PappaBears/Benairy-Windtunnel/cad/sweep_report.md

# Swept-angle interference check (generated by cad/check_sweep.py)

Metric parts rotated about the drum axis at x = 185, z = -65 mm.

| Configuration | Angle (deg) | Overlaps (part A / part B / mm3) |
|---|---|---|
| wing | -30 | strut_long / test_section_2 / 5.1 |
| wing | -25 | none |
| wing | -20 | none |
| wing | -15 | none |
| wing | -10 | none |
| wing | -5 | none |
| wing | +0 | none |
| wing | +5 | none |
| wing | +10 | none |
| wing | +15 | none |
| wing | +20 | none |
| wing | +25 | none |
| wing | +30 | none |
| car | -3 | none |
| car | -2 | none |
| car | -1 | none |
| car | +0 | none |
| car | +1 | none |
| car | +2 | none |
| car | +3 | none |

**Result: FAIL**
