PappaBears/Benairy-Windtunnel/docs/generated/design_numbers.md

# Design numbers (generated by tools/design_calcs.py)

Do not edit this file. Run the script again to update it.

## Operating point

| Quantity | Value |
|---|---|
| Fan | ARCTIC S12038-8K (120x120x38 mm, PWM, 12 V, 2.2 A) |
| Test section | 100 x 100 mm, 250 mm long |
| Contraction ratio | 4.0 |
| Total loss coefficient (on test-section q) | 1.63 |
| Volume flow | 0.0914 m^3/s (194 CFM) |
| Test-section speed | 9.1 m/s |
| Dynamic pressure q | 50.1 Pa |
| Fan pressure rise at this point | 82 Pa |
| Reynolds number on Dh | 60592 |
| Floor boundary layer at the model, laminar / turbulent | 2.7 / 6.5 mm |
| Turbulence factor, 2 screens x contraction | 0.145 |

## Loss coefficients

| Element | K (on q_ts) |
|---|---|
| honeycomb | 0.067 |
| screens | 0.090 |
| contraction | 0.020 |
| test_section | 0.050 |
| diffuser | 0.150 |
| exit | 1.153 |
| guard_and_model | 0.100 |
| total | 1.631 |

## Forces at the operating point

| Model | Quantity | Value |
|---|---|---|
| Wing 80 x 35 mm | Re (chord) | 21207 |
| Wing 80 x 35 mm | Lift at CL = 0.8 | 11.45 gf (112.3 mN) |
| Wing 80 x 35 mm | Drag at CD = 0.04 | 0.57 gf |
| Wing 80 x 35 mm | Drag at CD = 0.25 | 3.58 gf |
| Wing 80 x 35 mm | Frontal blockage at 15 deg | 7.2 % |
| 1:64 car | Re (length) | 45444 |
| 1:64 car | Drag at CD = 0.5 | 1.51 gf (14.8 mN) |
| 1:64 car | Lift at CL = 0.2 | 0.60 gf |
| 1:64 car | Frontal blockage | 5.9 % |
| Strut, airfoil section | Drag (tare) | 0.06 gf |
| Strut, round 3.5 mm rod | Drag (tare) | 0.80 gf |

## Balance budget (100 g drag cell, 200 g lift cell, HX711, 1 s average)

| Quantity | Value |
|---|---|
| Noise, 1 sigma | 0.010 g |
| Non-linearity | 0.050 g |
| Creep (half, after tare) | 0.015 g |
| Combined drag-cell uncertainty (100 g cell), 1 sigma | 0.053 g |
| Combined lift-cell uncertainty (200 g cell), 1 sigma | 0.105 g |
| Car drag, relative uncertainty | 3.5 % |
| Wing lift at CL 0.8, relative uncertainty | 0.9 % |
| Wing drag at CD 0.04, relative uncertainty | 9.3 % |

## Dynamic pressure budget (SDP810-125Pa)

| Quantity | Value |
|---|---|
| q uncertainty, 1 sigma | 1.51 Pa (3.0 %) |
| Speed uncertainty, 1 sigma | 1.5 % |
