PappaBears/Benairy-Windtunnel/cad/renders/rear_quarter.png

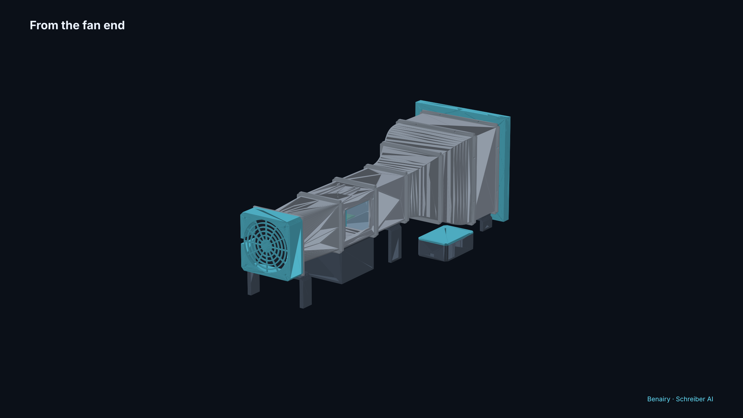
cad/renders/rear_quarter.png
