PappaBears/Benairy-Windtunnel/cad/renders/side.png

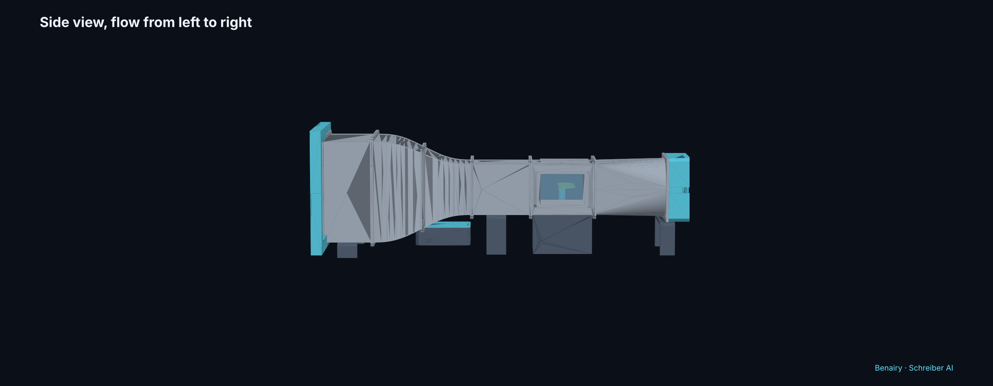
cad/renders/side.png
