PappaBears/Benairy-Windtunnel/cad/renders/sweep_arc.png

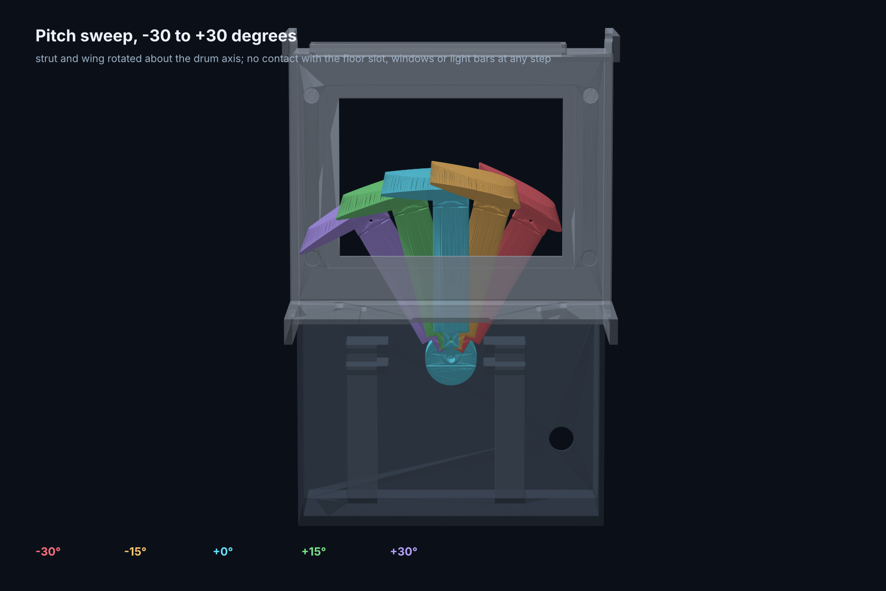
cad/renders/sweep_arc.png
