PappaBears/Benairy-Windtunnel/docs/images/dashboard_phone.png

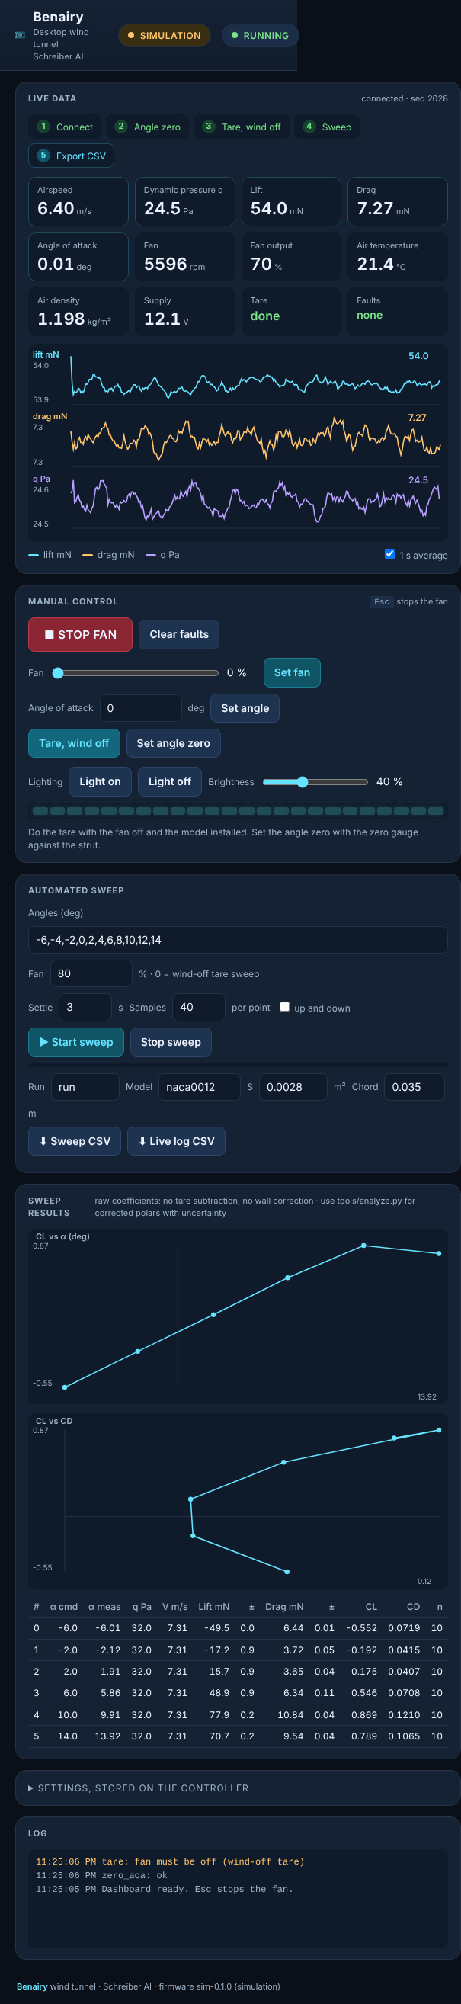
docs/images/dashboard_phone.png
