PappaBears/Benairy-Windtunnel/docs/images/dashboard_standalone_fault.png

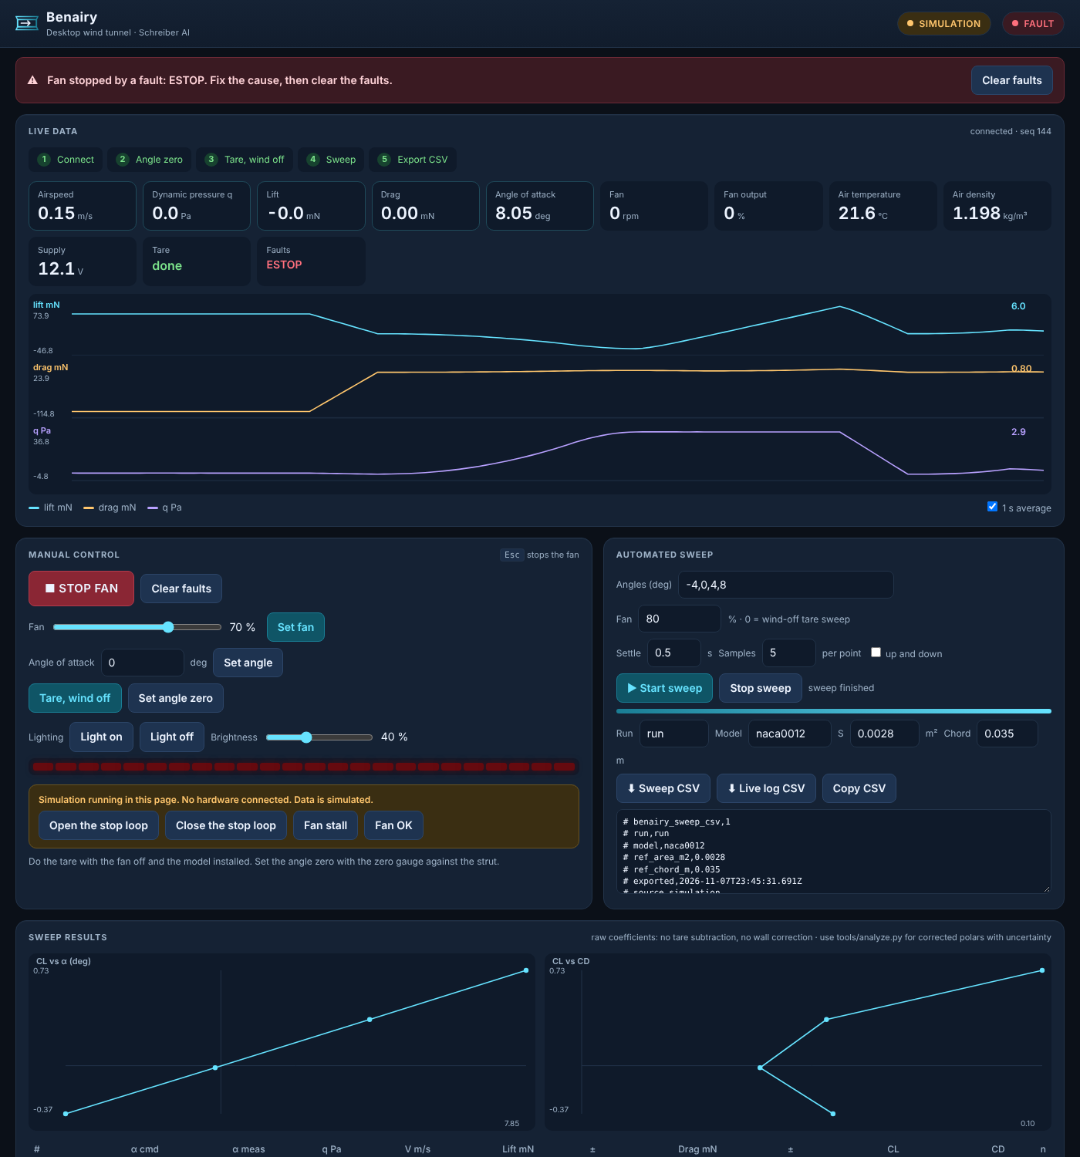
docs/images/dashboard_standalone_fault.png
