PappaBears/Benairy-Windtunnel/cad/renders/parts_gallery.png

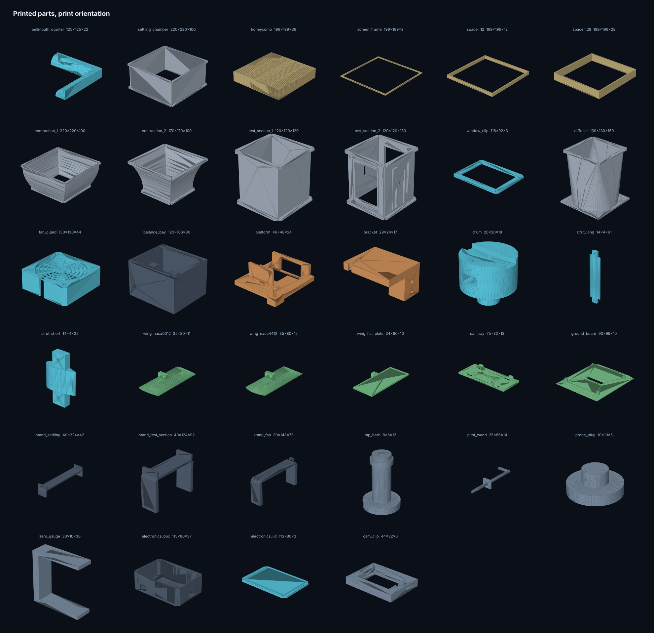
cad/renders/parts_gallery.png
