PappaBears/Benairy-Windtunnel/cad/assembly_stl/ground_board.stl

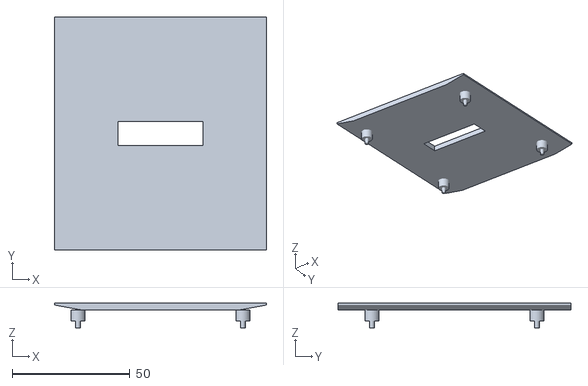
[picture p13: CAD file, 2026-11-08]
cad/assembly_stl/ground_board.stl
90.0 x 99.0 x 10.5
