PappaBears/Benairy-Windtunnel/cad/step/electronics_lid.step

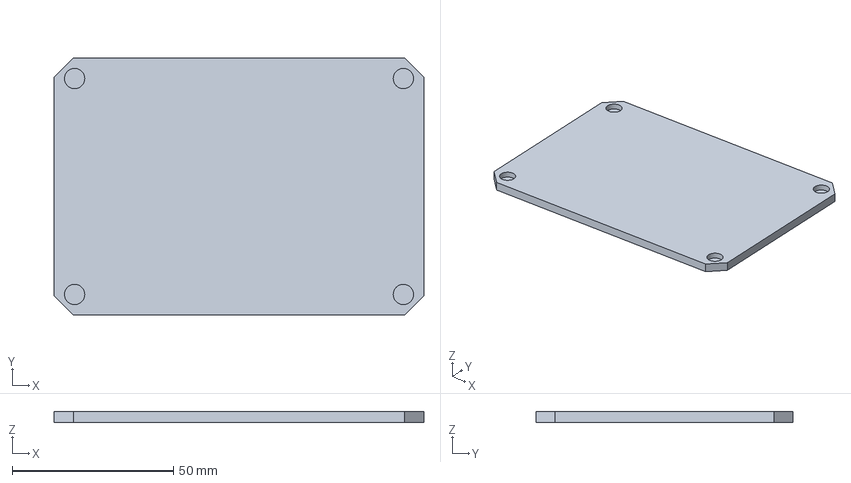
[picture p14: CAD file, 2026-11-08]
cad/step/electronics_lid.step
114.8 x 79.8 x 3.40 mm
