PappaBears/Benairy-Windtunnel/cad/assembly_stl/ref_led_strip_R.stl

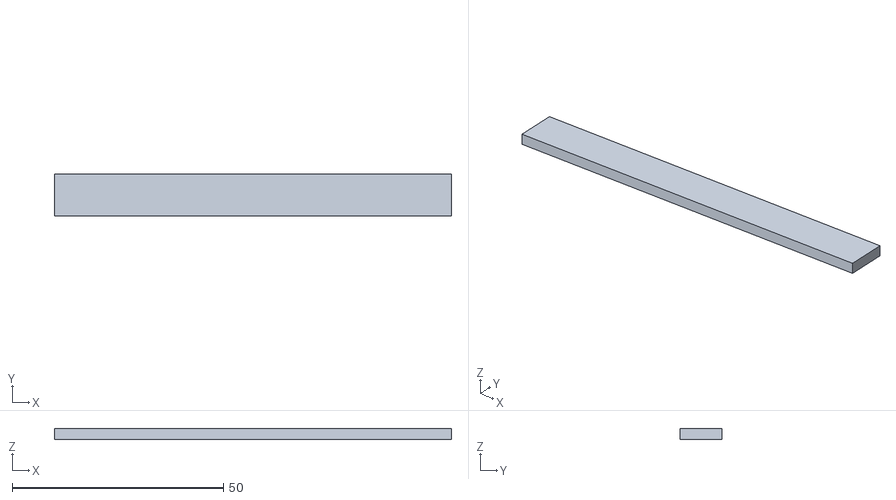
[picture p15: CAD file, 2026-11-07]
cad/assembly_stl/ref_led_strip_R.stl
94.0 x 10.0 x 2.60
