PappaBears/Benairy-Windtunnel/cad/step/settling_chamber.step

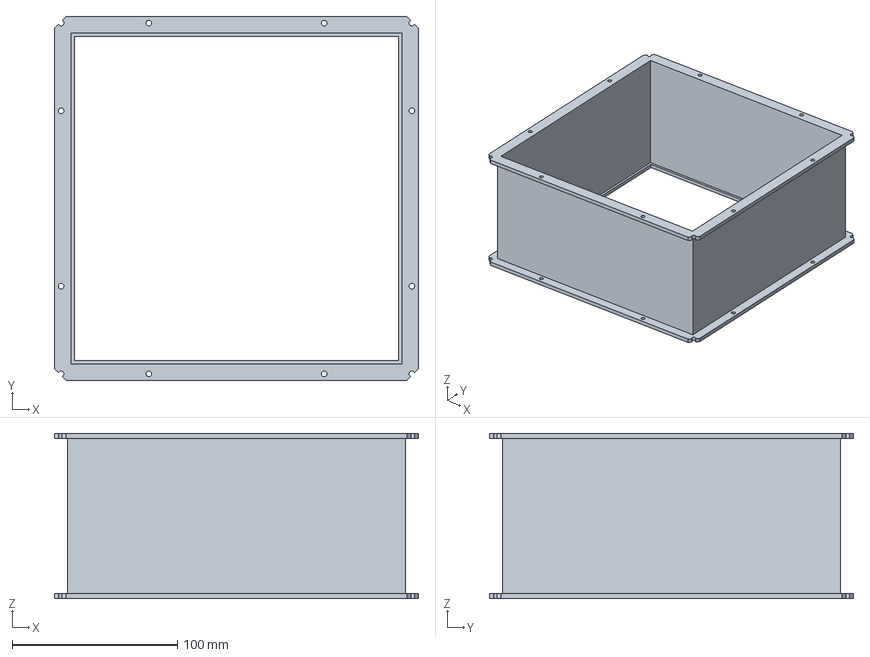
[picture p16: CAD file, 2026-11-08]
cad/step/settling_chamber.step
220.0 x 220.0 x 100.0 mm
