PappaBears/Benairy-Windtunnel/cad/step/wing_naca4412.step

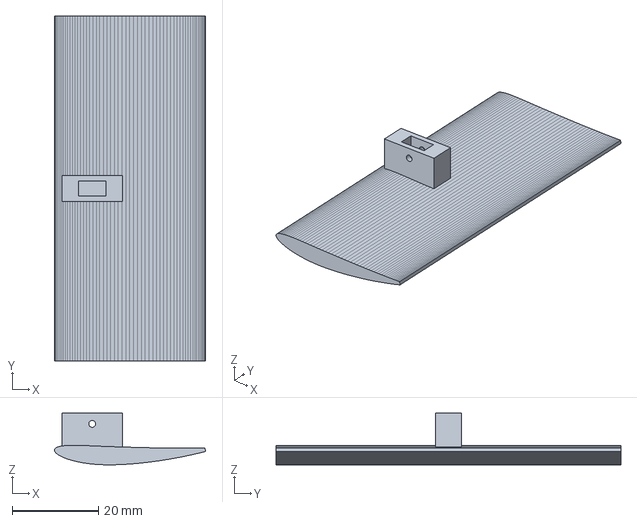
[picture p17: CAD file, 2026-11-08]
cad/step/wing_naca4412.step
35.1 x 80.0 x 12.0 mm
