PappaBears/Benairy-Windtunnel/cad/assembly_stl/test_section_2.stl

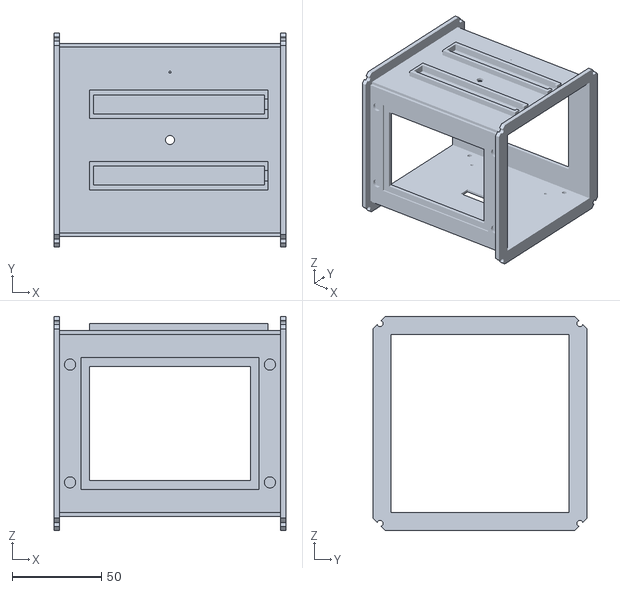
[picture p18: CAD file, 2026-11-07]
cad/assembly_stl/test_section_2.stl
130.0 x 120.0 x 120.0
