PappaBears/Benairy-Windtunnel/cad/step/diffuser.step

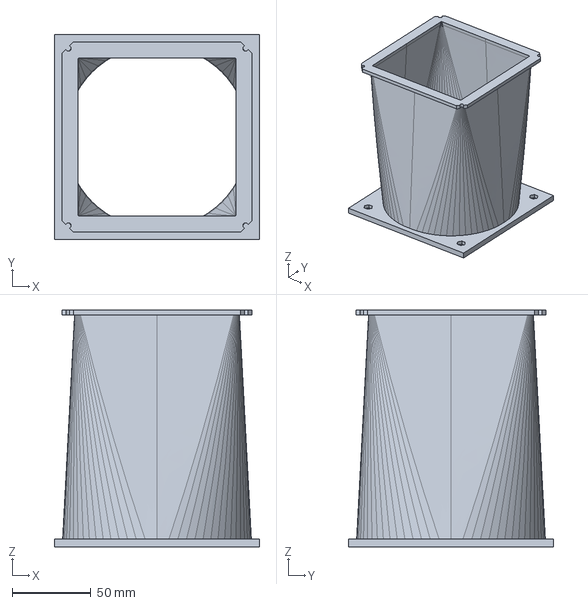
[picture p19: CAD file, 2026-11-08]
cad/step/diffuser.step
130.0 x 130.0 x 150.0 mm
