PappaBears/Benairy-Windtunnel/cad/assembly_stl/stand_fan.stl

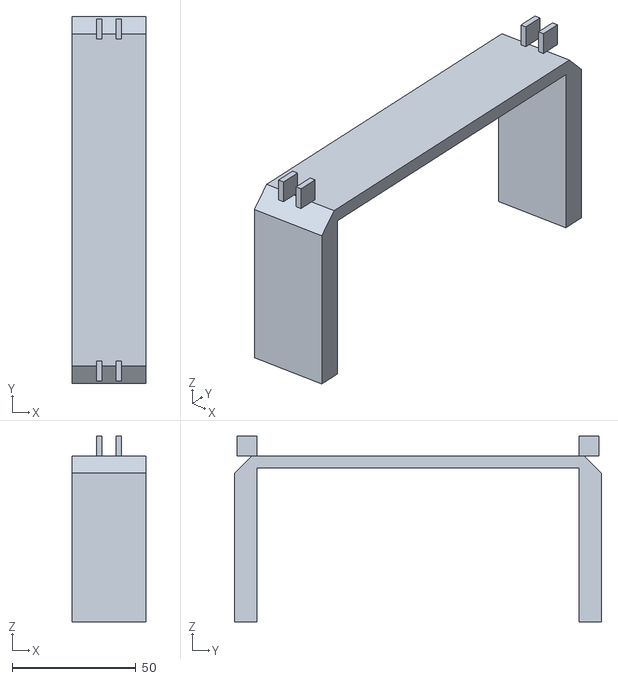
[picture p20: CAD file, 2026-11-07]
cad/assembly_stl/stand_fan.stl
30.0 x 148.0 x 75.0
