PappaBears/Benairy-Windtunnel/cad/step/platform.step

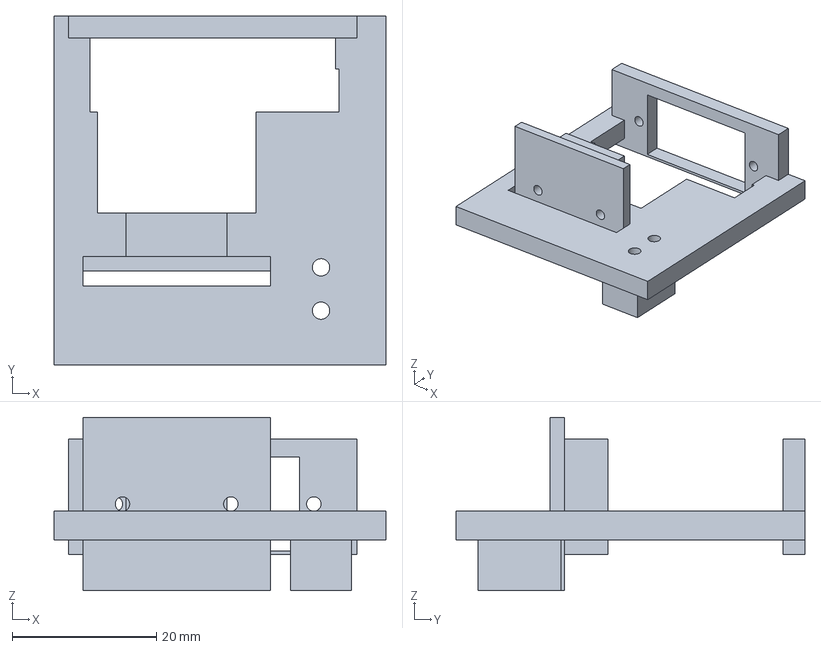
[picture p21: CAD file, 2026-11-08]
cad/step/platform.step
46.0 x 48.3 x 24.0 mm
