PappaBears/Benairy-Windtunnel/cad/assembly_stl/stand_test_section.stl

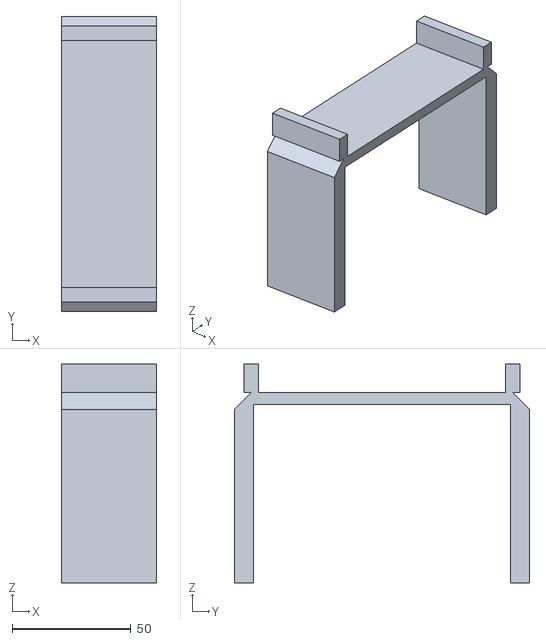
[picture p22: CAD file, 2026-11-07]
cad/assembly_stl/stand_test_section.stl
40.0 x 124.0 x 92.0
