PappaBears/Benairy-Windtunnel/cad/step/wing_flat_plate.step

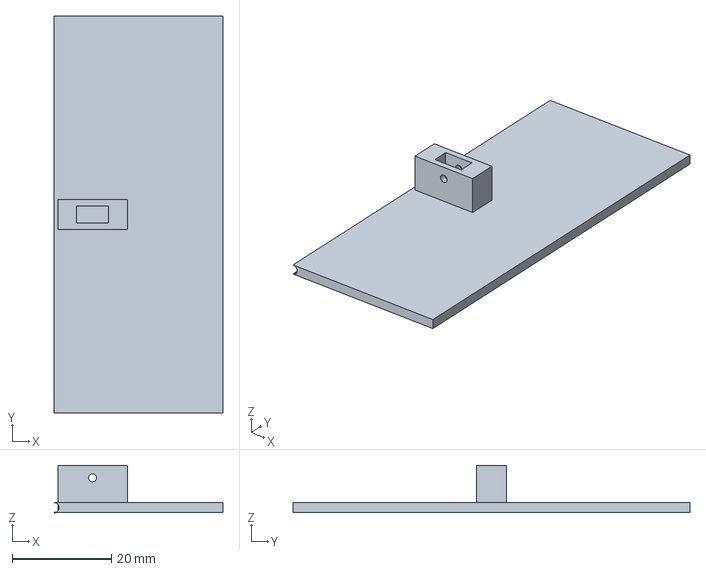
[picture p23: CAD file, 2026-11-08]
cad/step/wing_flat_plate.step
34.0 x 80.0 x 9.50 mm
