PappaBears/Benairy-Windtunnel/cad/step/pitot_wand.step

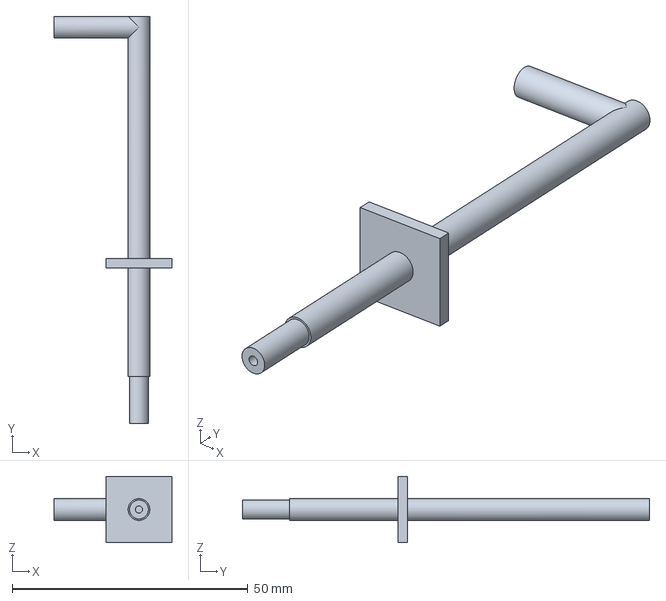
[picture p24: CAD file, 2026-11-08]
cad/step/pitot_wand.step
25.0 x 86.3 x 14.0 mm
