PappaBears/Benairy-Windtunnel/cad/assembly_stl/contraction_2.stl

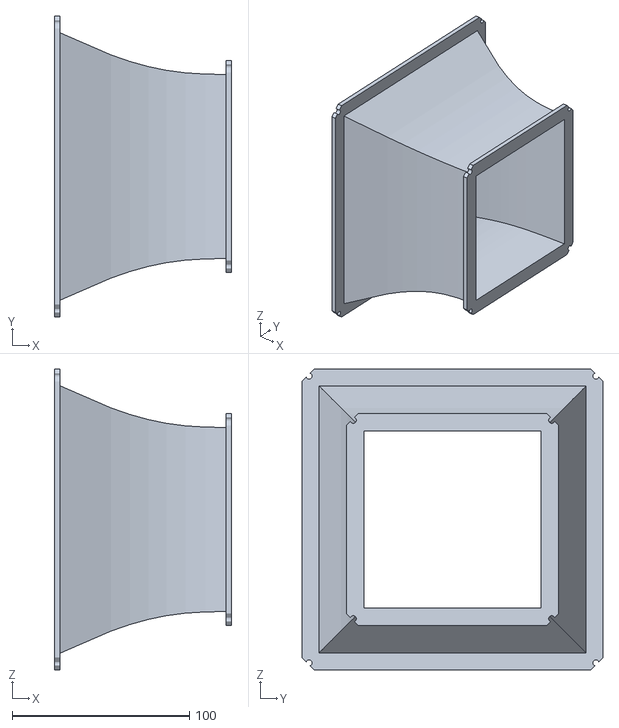
[picture p25: CAD file, 2026-11-07]
cad/assembly_stl/contraction_2.stl
100.0 x 170.0 x 170.0
