PappaBears/Benairy-Windtunnel/cad/step/stand_settling.step

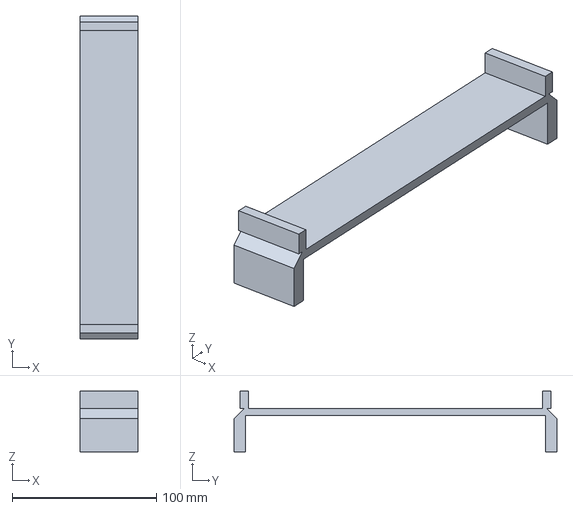
[picture p26: CAD file, 2026-11-08]
cad/step/stand_settling.step
40.0 x 224.0 x 42.0 mm
