PappaBears/Benairy-Windtunnel/cad/assembly_stl/fan_guard.stl

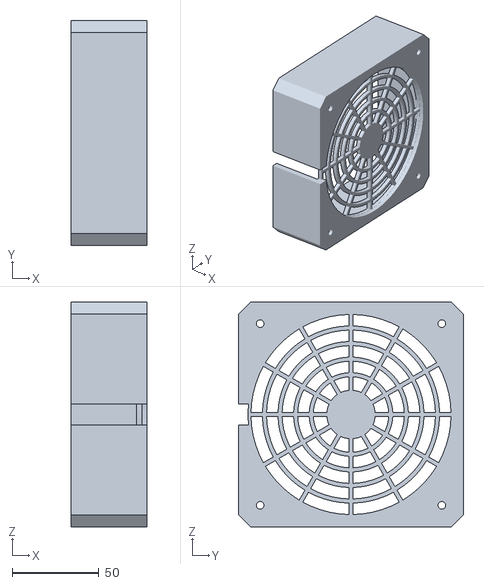
[picture p27: CAD file, 2026-11-07]
cad/assembly_stl/fan_guard.stl
44.0 x 130.0 x 130.0
