PappaBears/Benairy-Windtunnel/cad/assembly_stl/test_section_1.stl

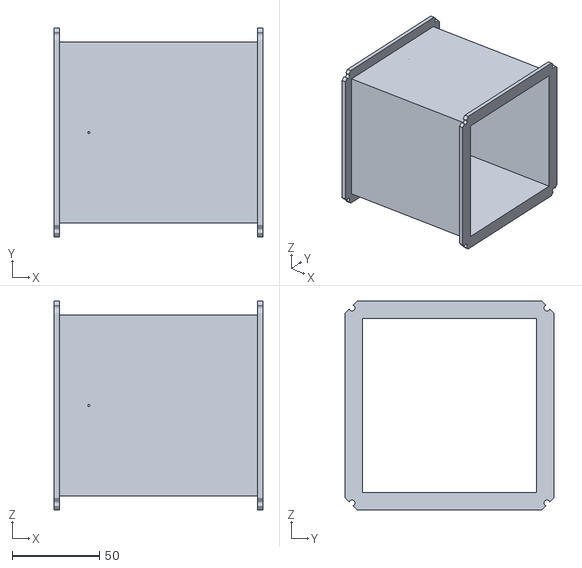
[picture p28: CAD file, 2026-11-07]
cad/assembly_stl/test_section_1.stl
120.0 x 120.0 x 120.0
