PappaBears/Benairy-Windtunnel/cad/step/electronics_box.step

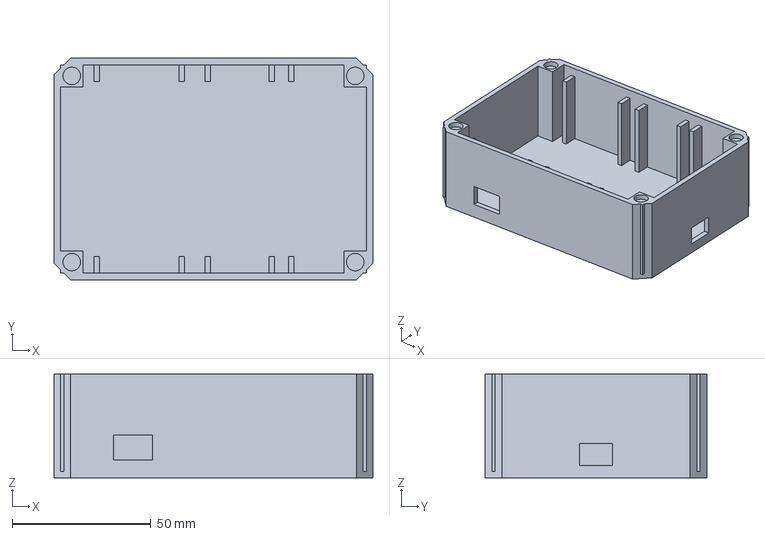
[picture p29: CAD file, 2026-11-08]
cad/step/electronics_box.step
114.8 x 79.8 x 37.4 mm
