PappaBears/Benairy-Windtunnel/cad/assembly_stl/window_clip.stl

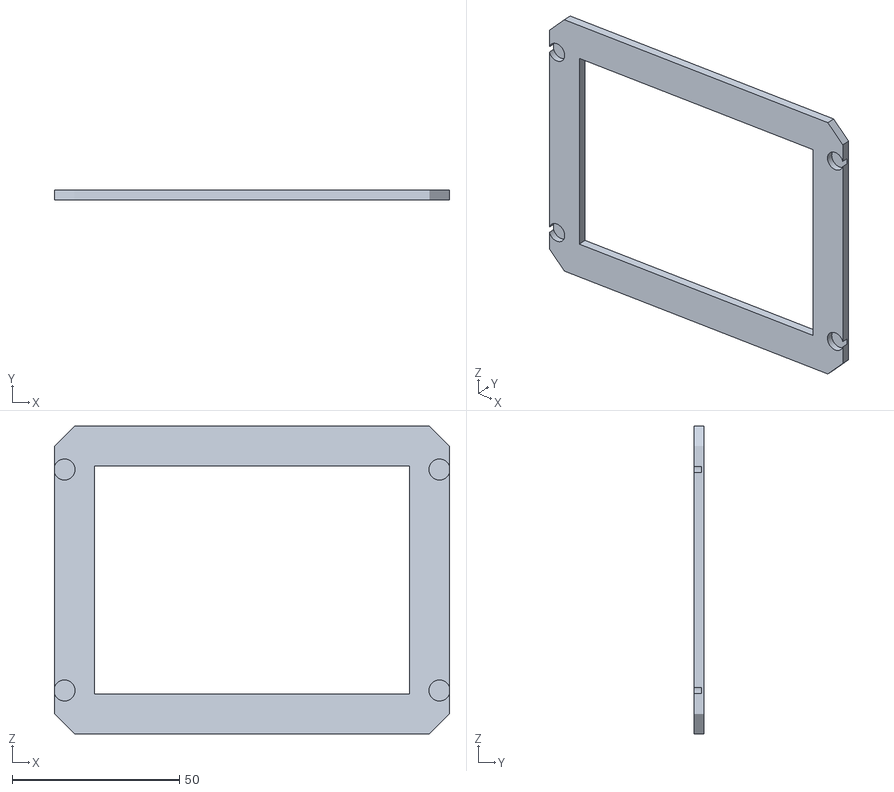
[picture p30: CAD file, 2026-11-07]
cad/assembly_stl/window_clip.stl
118.0 x 3.00 x 92.0
