PappaBears/Benairy-Windtunnel/cad/step/balance_bay.step

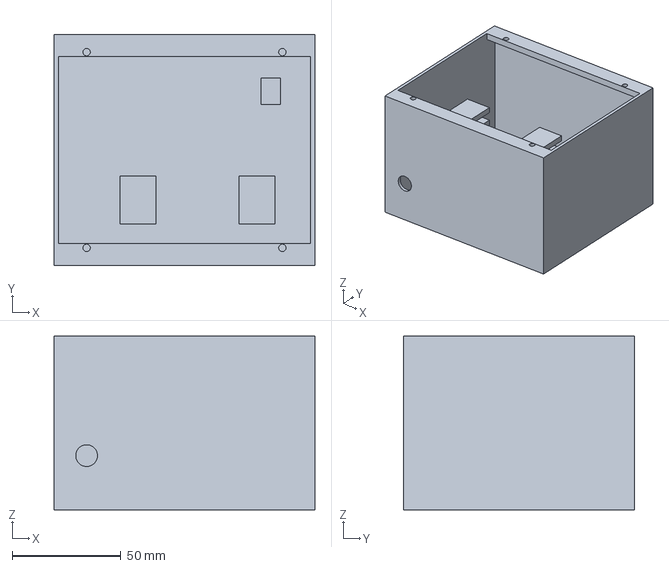
[picture p31: CAD file, 2026-11-08]
cad/step/balance_bay.step
120.0 x 106.0 x 80.0 mm
