PappaBears/Benairy-Windtunnel/cad/step/cam_clip.step

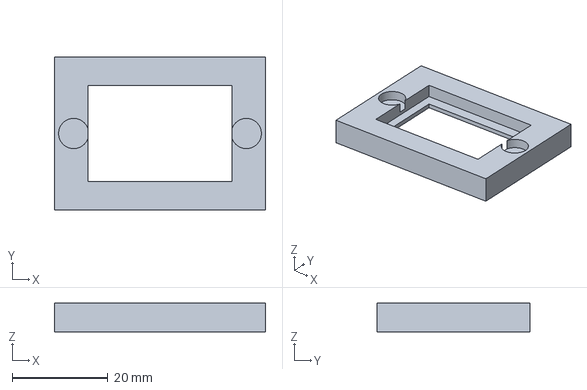
[picture p32: CAD file, 2026-11-08]
cad/step/cam_clip.step
44.0 x 32.0 x 6.00 mm
