PappaBears/Benairy-Windtunnel/cad/assembly_stl/contraction_1.stl

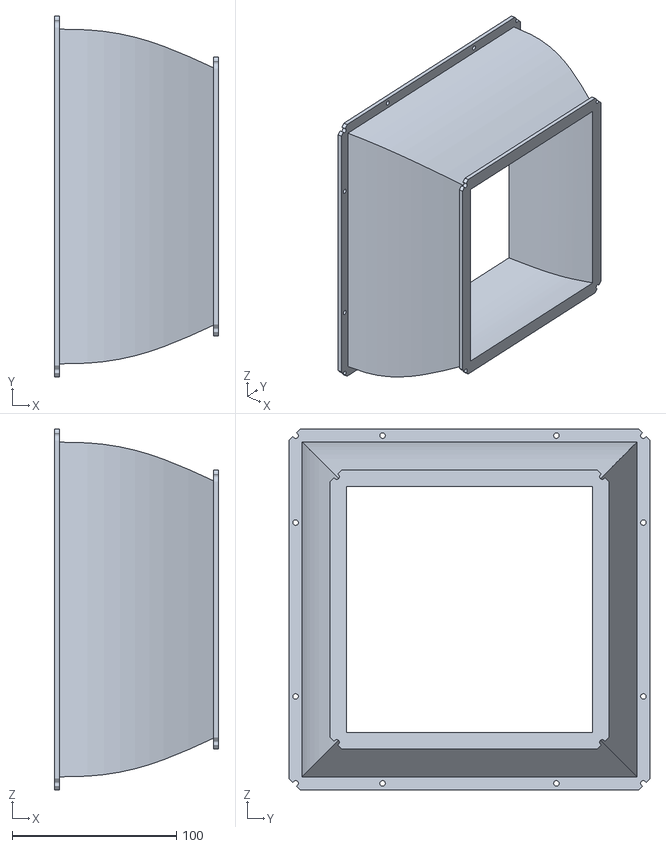
[picture p33: CAD file, 2026-11-07]
cad/assembly_stl/contraction_1.stl
100.0 x 220.0 x 220.0
