PappaBears/Benairy-Windtunnel/cad/step/screen_frame.step

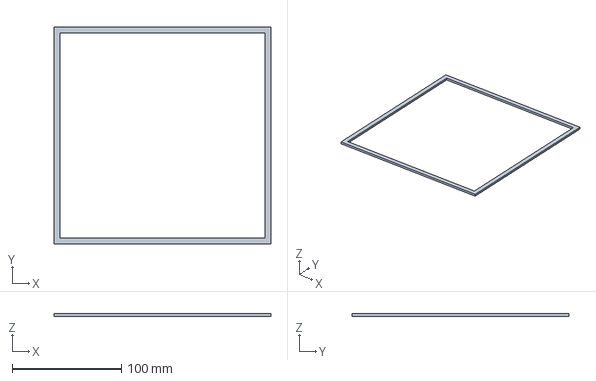
[picture p34: CAD file, 2026-11-08]
cad/step/screen_frame.step
199.0 x 199.0 x 2.50 mm
