PappaBears/Benairy-Windtunnel/cad/assembly_stl/ref_fan.stl

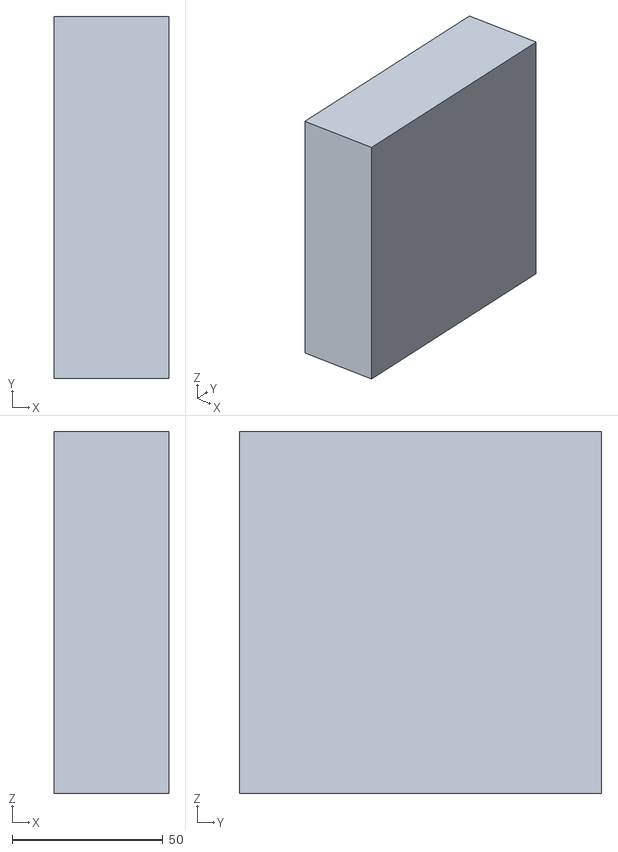
[picture p35: CAD file, 2026-11-07]
cad/assembly_stl/ref_fan.stl
38.0 x 120.0 x 120.0
