PappaBears/Benairy-Windtunnel/cad/step/tap_barb.step

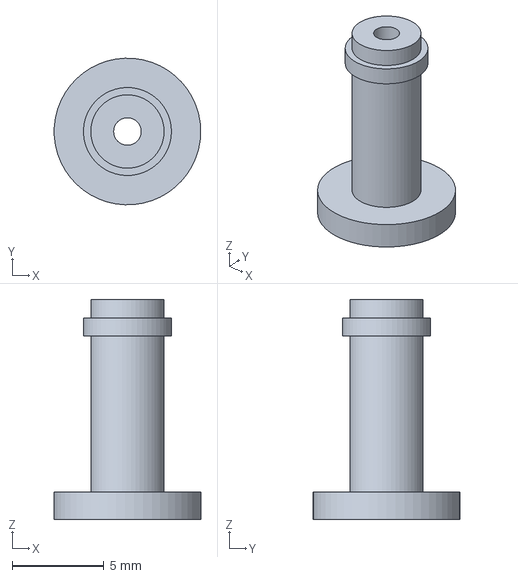
[picture p36: CAD file, 2026-11-08]
cad/step/tap_barb.step
7.99 x 8.00 x 12.0 mm
