PappaBears/Benairy-Windtunnel/cad/step/spacer_28.step

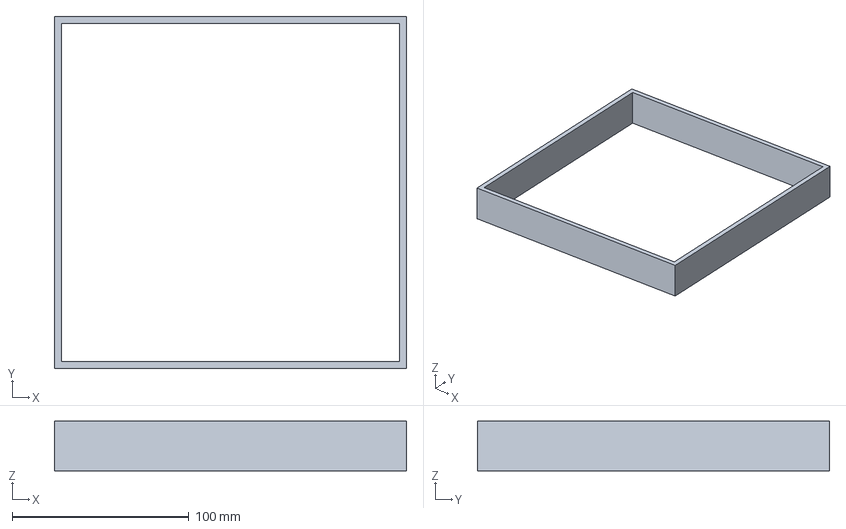
[picture p37: CAD file, 2026-11-08]
cad/step/spacer_28.step
199.0 x 199.0 x 28.0 mm
