PappaBears/Benairy-Windtunnel/cad/assembly_stl/spacer_12.stl

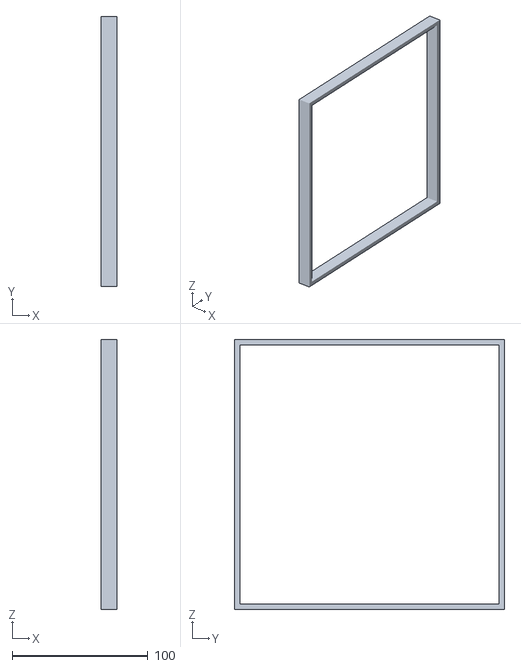
[picture p38: CAD file, 2026-11-07]
cad/assembly_stl/spacer_12.stl
12.0 x 199.0 x 199.0
