PappaBears/Benairy-Windtunnel/cad/step/drum.step

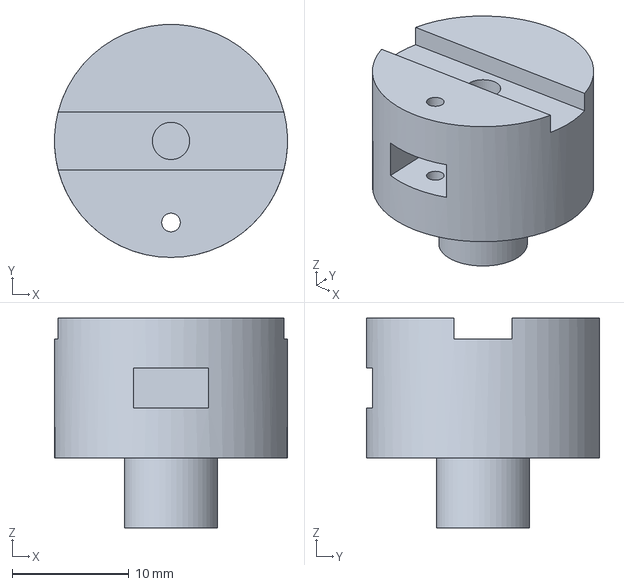
[picture p39: CAD file, 2026-11-08]
cad/step/drum.step
20.0 x 20.0 x 18.0 mm
