PappaBears/Benairy-Windtunnel/cad/step/honeycomb.step

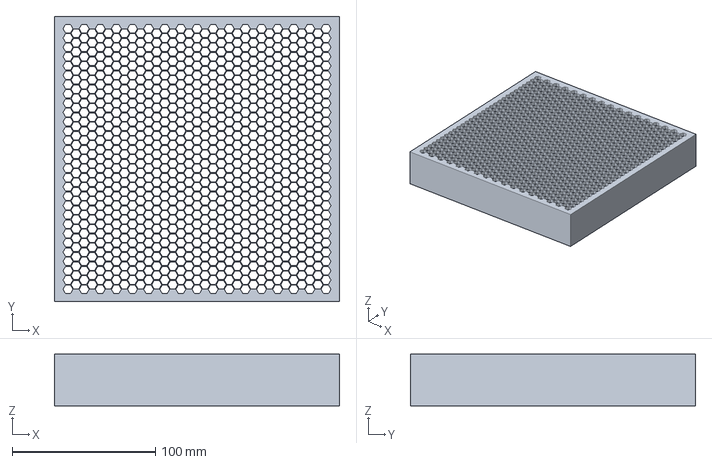
[picture p40: CAD file, 2026-11-08]
cad/step/honeycomb.step
199.0 x 199.0 x 36.0 mm
