PappaBears/Benairy-Windtunnel/cad/assembly_stl/ref_window_sheet_L.stl

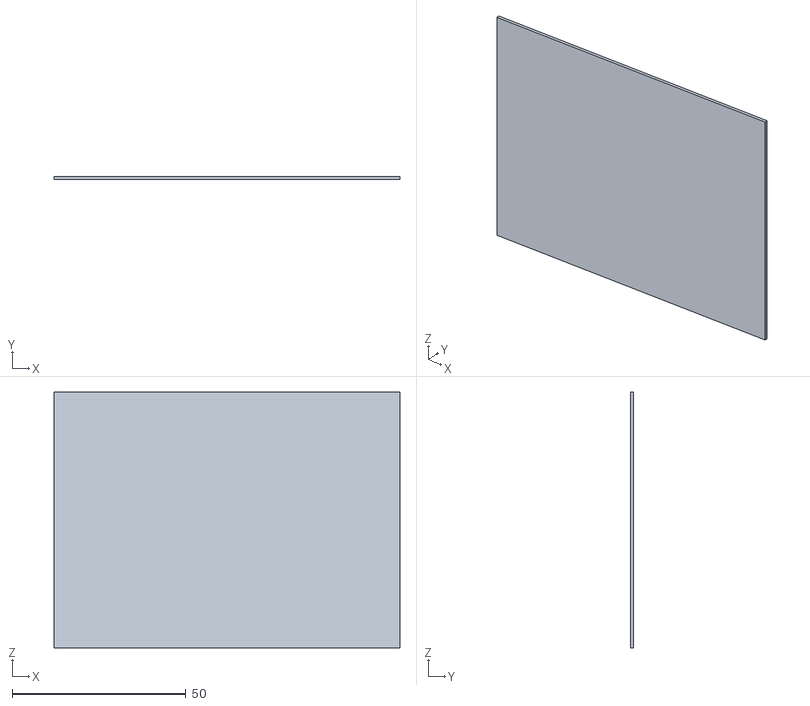
[picture p41: CAD file, 2026-11-07]
cad/assembly_stl/ref_window_sheet_L.stl
99.6 x 1.00 x 73.6
