PappaBears/Benairy-Windtunnel/cad/assembly_stl/bellmouth_quarter.stl

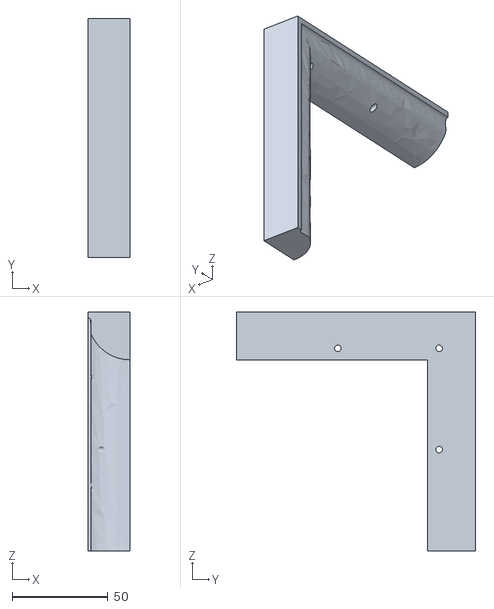
[picture p42: CAD file, 2026-11-07]
cad/assembly_stl/bellmouth_quarter.stl
22.0 x 125.0 x 125.0
