PappaBears/Benairy-Windtunnel/cad/step/probe_plug.step

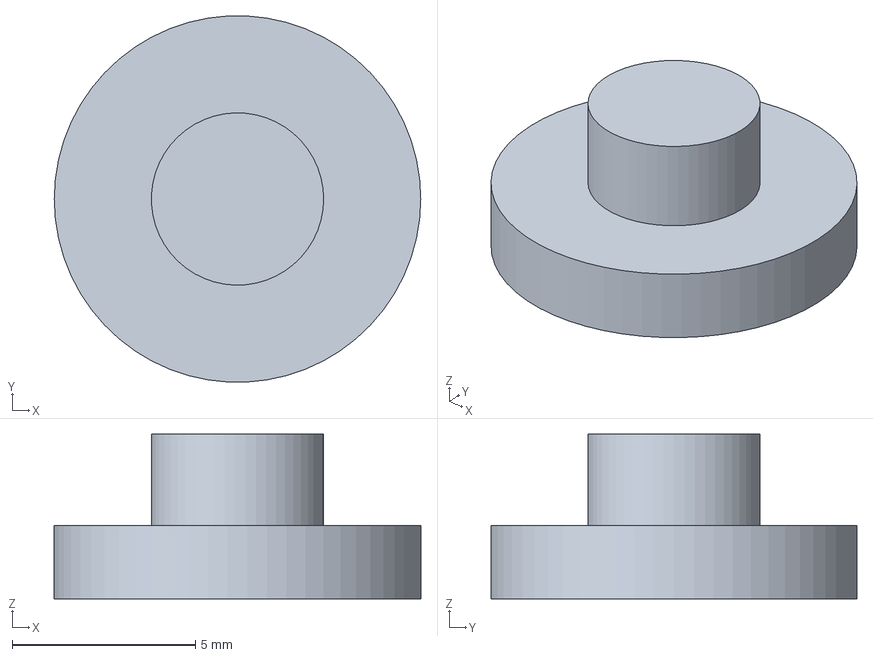
[picture p43: CAD file, 2026-11-08]
cad/step/probe_plug.step
10.0 x 9.99 x 4.50 mm
