PappaBears/Benairy-Windtunnel/cad/assembly_stl/strut_long.stl

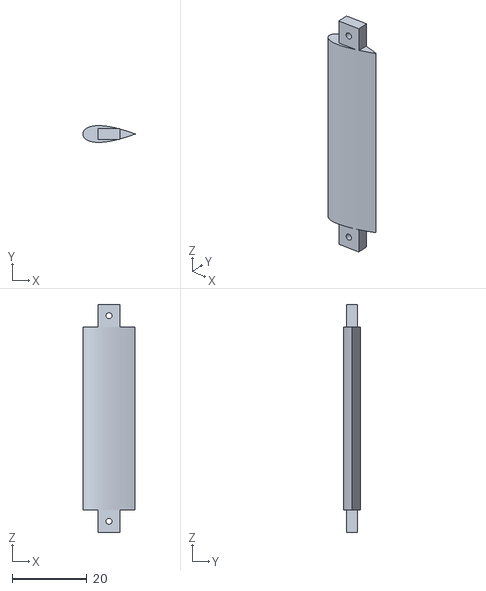
[picture p44: CAD file, 2026-11-07]
cad/assembly_stl/strut_long.stl
14.0 x 4.50 x 61.0
