PappaBears/Benairy-Windtunnel/cad/step/wing_naca0012.step

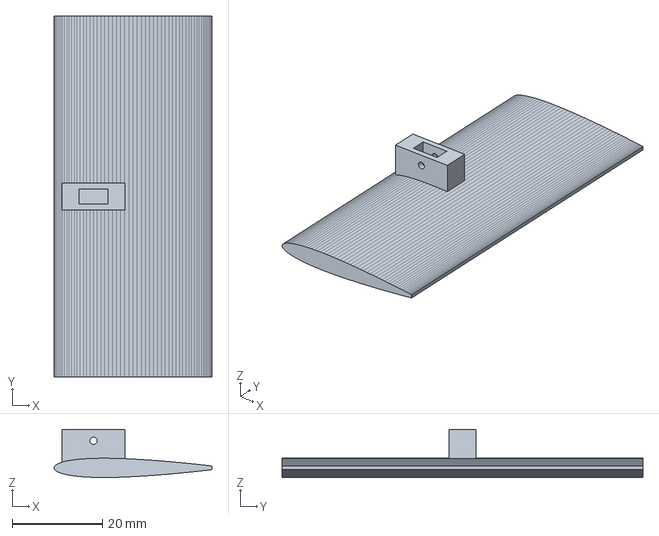
[picture p45: CAD file, 2026-11-08]
cad/step/wing_naca0012.step
35.0 x 80.0 x 10.6 mm
