PappaBears/Benairy-Windtunnel/cad/step/bracket.step

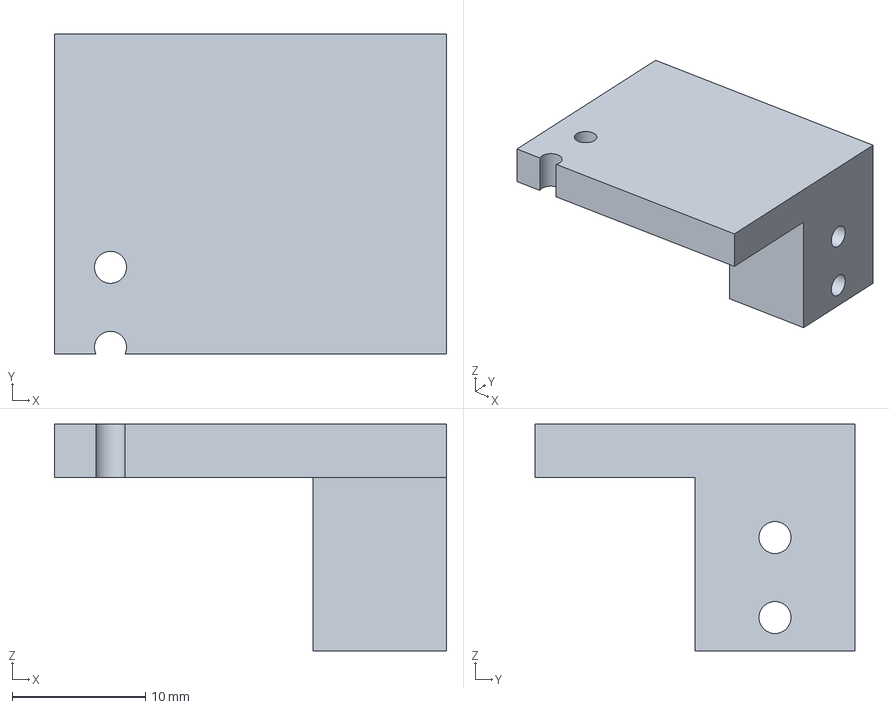
[picture p46: CAD file, 2026-11-08]
cad/step/bracket.step
29.4 x 24.0 x 17.0 mm
