PappaBears/Benairy-Windtunnel/cad/assembly_stl/ref_servo.stl

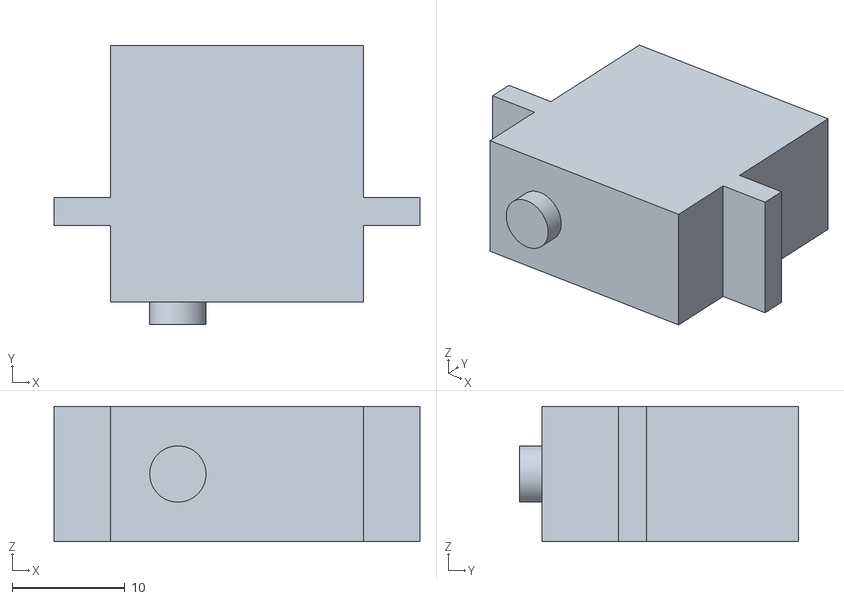
[picture p47: CAD file, 2026-11-07]
cad/assembly_stl/ref_servo.stl
32.5 x 24.8 x 12.0
