PappaBears/Benairy-Windtunnel/cad/step/strut_short.step

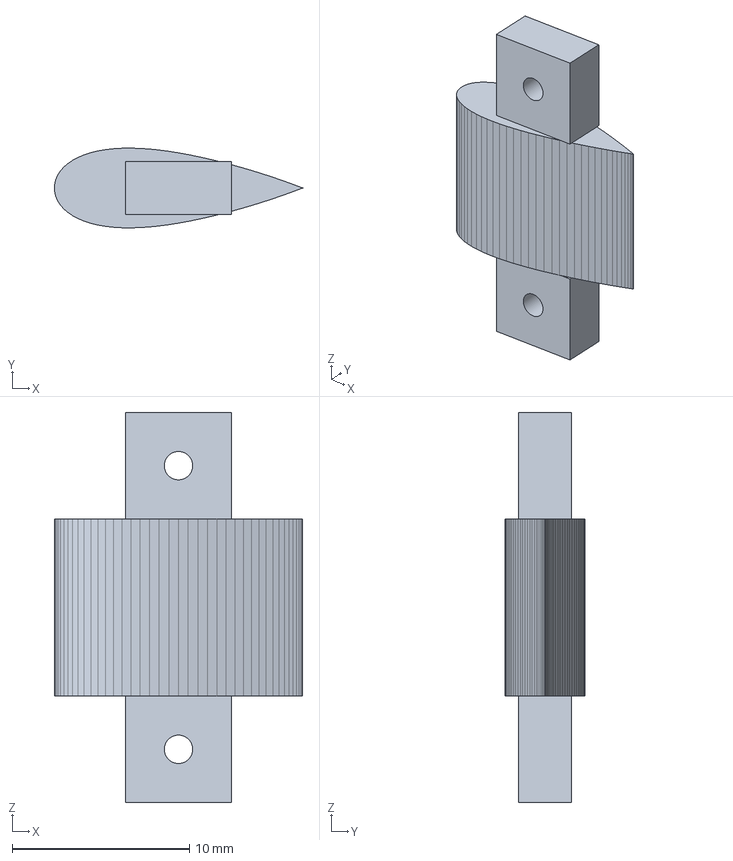
[picture p48: CAD file, 2026-11-08]
cad/step/strut_short.step
14.0 x 4.50 x 22.0 mm
