PappaBears/Benairy-Windtunnel/cad/step/car_tray.step

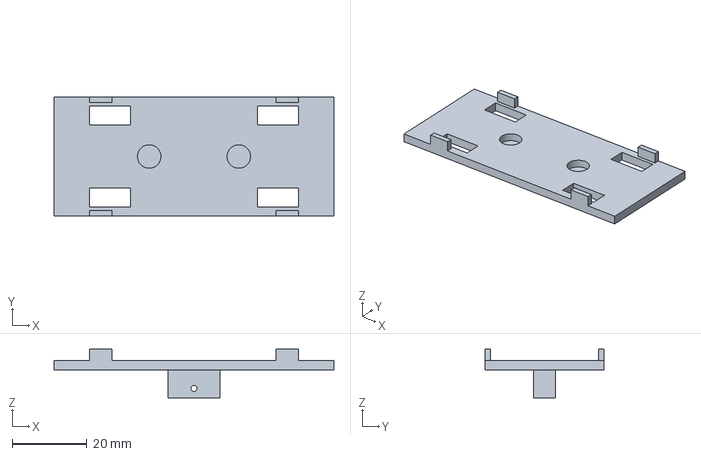
[picture p49: CAD file, 2026-11-08]
cad/step/car_tray.step
75.0 x 32.0 x 13.0 mm
