PappaBears/Benairy-Windtunnel/cad/assembly_stl/ref_lift_cell.stl

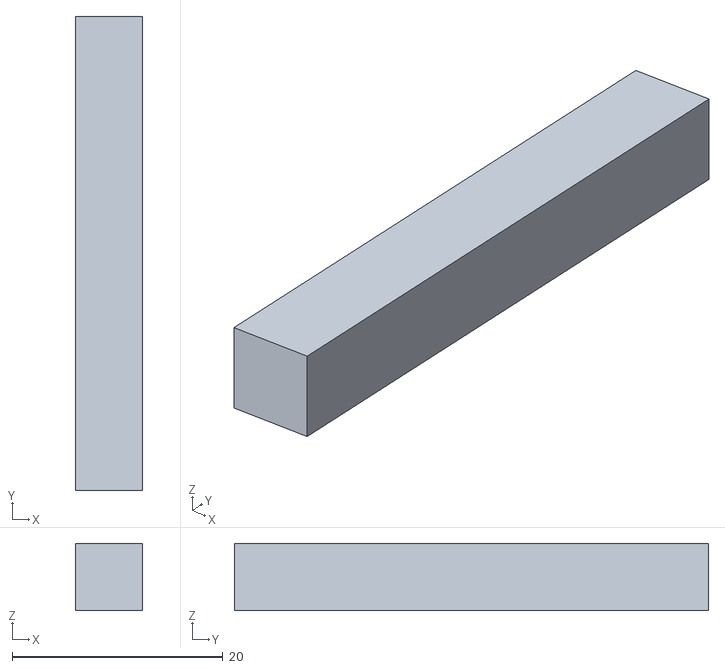
[picture p50: CAD file, 2026-11-07]
cad/assembly_stl/ref_lift_cell.stl
6.40 x 45.0 x 6.40
