PappaBears/Benairy-Windtunnel/cad/step/zero_gauge.step

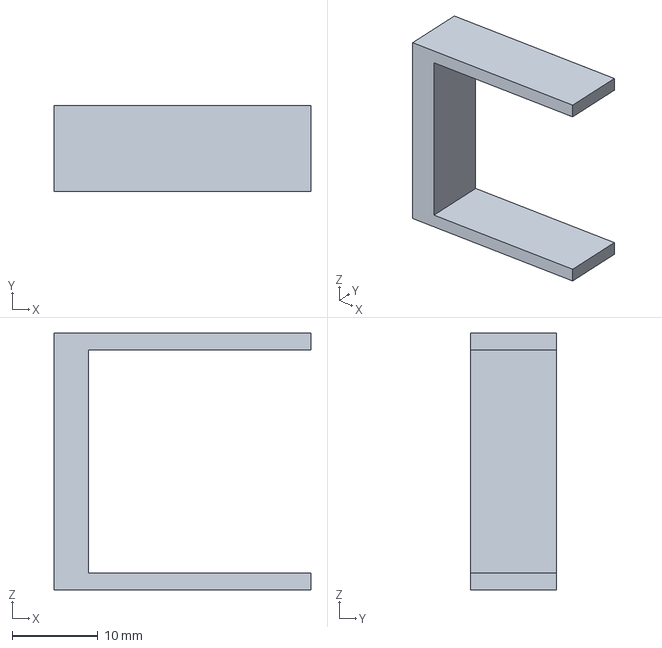
[picture p51: CAD file, 2026-11-08]
cad/step/zero_gauge.step
30.0 x 10.0 x 30.0 mm
