PappaBears/Benairy-Windtunnel/cad/assembly_stl/ref_as5600.stl

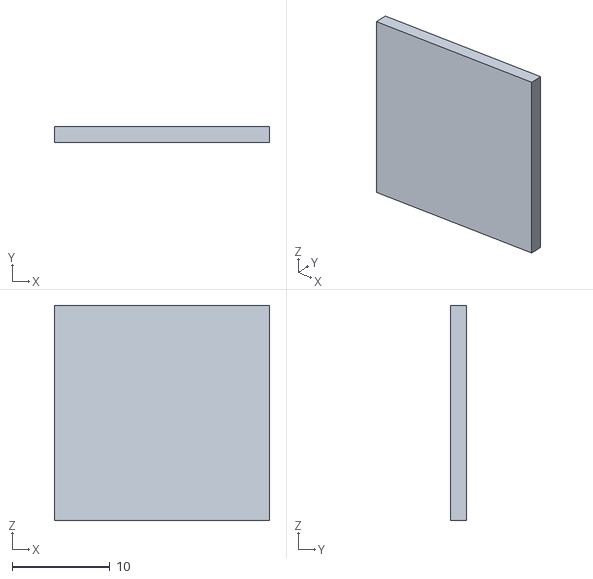
[picture p52: CAD file, 2026-11-07]
cad/assembly_stl/ref_as5600.stl
22.0 x 1.60 x 22.0
