PappaBears/Benairy-Windtunnel/cad/assembly_stl/ref_car.stl

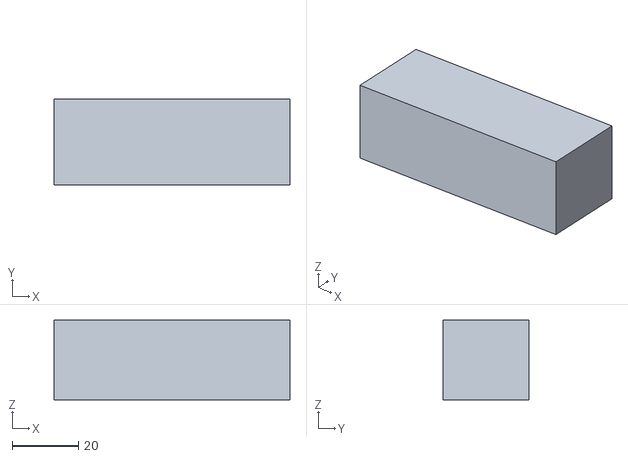
[picture p53: CAD file, 2026-11-07]
cad/assembly_stl/ref_car.stl
71.0 x 26.0 x 24.0
