PappaBears/Benairy-Windtunnel/(list of files, cad)

Other CAD files:
cad/assembly_stl/ref_led_strip_L.stl
cad/assembly_stl/electronics_lid.stl
cad/step/test_section_2.step
cad/assembly_stl/settling_chamber.stl
cad/step/stand_test_section.step
cad/step/stand_fan.step
cad/assembly_stl/electronics_box.stl
cad/assembly_stl/diffuser.stl
cad/step/window_clip.step
cad/assembly_stl/stand_settling.stl
cad/assembly_stl/tap_barb.stl
cad/step/test_section_1.step
cad/assembly_stl/balance_bay.stl
cad/assembly_stl/cam_clip.stl
cad/step/contraction_1.step
cad/assembly_stl/ref_window_sheet_R.stl
cad/step/ground_board.step
cad/step/strut_long.step
cad/assembly_stl/spacer_28.stl
cad/assembly_stl/spacer_12_pos2.stl
cad/step/spacer_12.step
cad/assembly_stl/wing_flat_plate.stl
cad/assembly_stl/screen_frame_A_pos.stl
cad/step/contraction_2.step
cad/step/bellmouth_quarter.step
cad/assembly_stl/screen_frame.stl
cad/assembly_stl/drum.stl
cad/step/fan_guard.step
cad/assembly_stl/wing_naca0012.stl
cad/assembly_stl/pitot_wand.stl
cad/assembly_stl/bracket.stl
cad/assembly_stl/zero_gauge.stl
cad/assembly_stl/honeycomb.stl
cad/assembly_stl/car_tray.stl
cad/assembly_stl/probe_plug.stl
cad/assembly_stl/strut_short.stl
cad/assembly_stl/ref_drag_cell.stl
cad/assembly_stl/wing_naca4412.stl
cad/assembly_stl/platform.stl
cad/stl/balance_bay.stl
cad/stl/bellmouth_quarter.stl
cad/stl/bracket.stl
cad/stl/cam_clip.stl
cad/stl/car_tray.stl
cad/stl/contraction_1.stl
cad/stl/contraction_2.stl
cad/stl/diffuser.stl
cad/stl/drum.stl
cad/stl/electronics_box.stl
cad/stl/electronics_lid.stl
cad/stl/fan_guard.stl
cad/stl/ground_board.stl
cad/stl/honeycomb.stl
cad/stl/pitot_wand.stl
cad/stl/platform.stl
cad/stl/probe_plug.stl
cad/stl/screen_frame.stl
cad/stl/settling_chamber.stl
cad/stl/spacer_12.stl
cad/stl/spacer_28.stl
cad/stl/stand_fan.stl
cad/stl/stand_settling.stl
cad/stl/stand_test_section.stl
cad/stl/strut_long.stl
cad/stl/strut_short.stl
cad/stl/tap_barb.stl
cad/stl/test_section_1.stl
cad/stl/test_section_2.stl
cad/stl/window_clip.stl
cad/stl/wing_flat_plate.stl
cad/stl/wing_naca0012.stl
cad/stl/wing_naca4412.stl
cad/stl/zero_gauge.stl
