PappaBears/Benairy-Windtunnel/data/examples/sim_calibration.csv

applied_lift_g | applied_drag_g | lift_raw | drag_raw
0 | 0 | 123456 | -98759
0 | 0 | 123450 | -98761
2 | 0 | 143080 | -98760
0 | 2 | 123867 | -79162
5 | 0 | 172490 | -98773
0 | 5 | 124427 | -49734
10 | 0 | 221525 | -98760
0 | 10 | 125423 | -672
20 | 0 | 319599 | -98784
0 | 20 | 127381 | 97361
0 | 0 | 123450 | -98749
0 | 0 | 123453 | -98788
2 | 0 | 143073 | -98768
0 | 2 | 123834 | -79163
5 | 0 | 172482 | -98765
0 | 5 | 124432 | -49731
10 | 0 | 221545 | -98775
0 | 10 | 125408 | -701
20 | 0 | 319602 | -98773
0 | 20 | 127396 | 97352
0 | 0 | 123444 | -98766
0 | 0 | 123446 | -98772
