PappaBears/Benairy-Windtunnel/data/examples/calibration/calibration.png

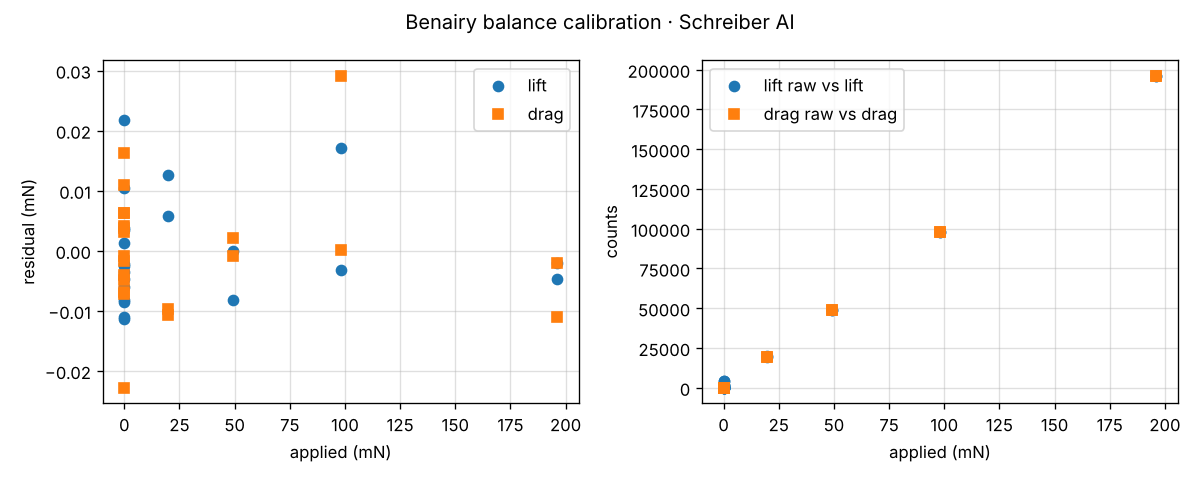
data/examples/calibration/calibration.png
