PappaBears/Benairy-Windtunnel/(commit log)

2026-11-07 CAD generator, STL/STEP export, printability and interference checks, design calculations
    Claude-Session: https://claude.ai/code/session_01THwUixJFEXNopwHx1FBGmW
    [balance_bay.step, balance_bay.stl, bellmouth_quarter.step, bellmouth_quarter.stl, bracket.step, bracket.stl, cam_clip.step, cam_clip.stl]
2026-11-07 Firmware, dashboard, simulator, analysis tools, tests, documentation
    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
    [processed.csv, sim_calibration.csv, sim_wing_run.csv, sim_wing_tare.csv]
2026-11-07 Correct the filament estimate from the manifest volumes
    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
2026-11-07 Revision pass: chamfered flanges, fan cowl, sculpted stands, magnet covers, brand renders, restyled dashboard
    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
    [balance_bay.step, bellmouth_quarter.step, bracket.step, cam_clip.step, car_tray.step, contraction_1.step, contraction_1.stl, contraction_2.step]
2026-11-07 Lighting: WS2812B light bars on the test section, state colours in firmware and simulator, dashboard controls, tests, docs
    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
    [balance_bay.step, bellmouth_quarter.step, bracket.step, cam_clip.step, car_tray.step, contraction_1.step, contraction_2.step, diffuser.step]
2026-11-07 Standalone dashboard with an in-page simulator; build script for ESP32, standalone and artifact variants
    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
2026-11-08 Swept-angle interference check; widen the ground board gap so car rake of +-3 deg clears
    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
    [balance_bay.step, bellmouth_quarter.step, bracket.step, cam_clip.step, car_tray.step, contraction_1.step, contraction_2.step, diffuser.step]
